mahdiqnb/Heater/docs/LINKEDIN_POST_FA.md

# پست لینکدین — HEATER V2.0

> متن آماده کپی است. فقط اگر خواستی جزئیات شخصی (مثل مدت زمان کار یا اسم پروژه قبلی) را عوض کن.
> عکس برد را خودت باید اضافه کنی: فایل را با نام `board.png` در `docs/images/` بگذار تا ترتیب عکس‌ها کامل شود.

---

## متن پست

🔥 یه مدت درگیر یه چیز کوچیک بودم: اینکه دما ثابت بمونه!

تا حالا شده هویه رو تنظیم کنی، بری یه قطعه رو بردار بیاری، برگردی ببینی دما ۴۰ درجه پریده؟ 😅
یا هیتر یه لحظه قطع و وصل بشه و کارت رو خراب کنه؟

برای همین یه کنترلر دو کاناله ساختم؛ یکی برای هیتر با حلقه بسته PID و یکی برای هویه با توان دستی. هر دو روی یه برد، با یه میکروکنترلر.

🔹 داخلش چی هست؟
- STM32G070RB با کلاک ۶۴ مگاهرتز
- اندازه‌گیری واقعی ترموکوپل Type-K با INA826 و جبران اتصال سرد با SHT40
- دیمر فاز دو کاناله با BTA16 و MOC3021
- LCD گرافیکی ۳۲۰×۲۴۰ با رابط کاربری و فونت اختصاصی
- دو فن PWM، چهار کلید و ذخیره تنظیمات روی فلش

🔹 سخت‌ترین بخشش کجا بود؟
جایی که همه‌چیز «به نظر» درست بود ولی نبود 😂
با توان ثابت ۲٪، دما بین ۱۳۲ تا ۱۶۳ درجه بالا و پایین می‌رفت. مشکل از PID نبود؛ پنجره هدایت تریاک در توان پایین فقط ۴۰۰ میکروثانیه بود و کوچک‌ترین جیتر صفر کراس، توان تحویلی رو حدود ۲۰٪ تغییر می‌داد.
راه‌حل: زیر ۲۰٪ به‌جای کنترل فاز، burst firing (نیم‌سیکل کامل روشن/خاموش) و تفکیک ۰٫۰۱٪ برای خروجی PID.

🔹 یه نکته که خوب یادم موند:
نویز فایر شدن تریاک روی همون خط صفر کراس می‌افته و می‌تونه کانال دیگر رو خاموش کنه. با یه شبکه زمانی مستقل روی TIM3 که فقط با صفر کراس واقعی قفل می‌شه، این مشکل حل شد.

📐 کل پروژه (کد، شماتیک، PCB و BOM) روی گیت‌هاب در دسترسه:
🔗 github.com/mahdiqnb/Heater

اگه پروژه مشابهی داشتی یا سوال فنی داری، کامنت بذار 👇

#Electronics #EmbeddedSystems #HardwareDesign #PCBDesign #ElectronicsEngineering #PCB

---

## ترتیب پیشنهادی عکس‌ها

1. `docs/images/hero.png` — کاور پست
2. `docs/images/ui-home.png` — صفحه اصلی دستگاه
3. `docs/images/ui-settings.png` — صفحه تنظیمات
4. `docs/images/block-diagram.png` — دیاگرام سیستم
5. `docs/images/board.png` — عکس یا رندر برد (خودت اضافه کن)
6. `docs/images/ui-about.png` — صفحه درباره (اختیاری)

## چند نکته

- لینک گیت‌هاب را در اولین کامنت هم بگذار؛ بعضی الگوریتم‌ها پست‌های دارای لینک را کمتر نشان می‌دهند.
- اگر خواستی پست کوتاه‌تر شود، بخش «سخت‌ترین بخشش کجا بود» را نگه دار و یکی از بولت‌های مشخصات را حذف کن؛ همان بخش بیشترین تعامل را می‌گیرد.
- برای عکس برد، نور یکنواخت و پس‌زمینه تیره (مثل بقیه تصاویر) بهترین نتیجه را می‌دهد.
