mahdiqnb/Heater/hardware/BOM/My Heater BOM.xlsx

Comment | Designator | Quantity | Price | Price x Quantity | Link | UNIT PRICE | TOTAL
AMS1117 3.3V | A600 | 1 |  |  | lionelectronic (https://lionelectronic.ir/products/868-AMS1117-3.3) | 180699 | 180699
Bat54s | B100, B101, B102, B103, B104, B106, B107, B108, B109, B110 | 10 |  |  | lionelectronic (https://lionelectronic.ir/products/2416-BAT54S) | 99477 | 994770
BC817 | B700, B701, B702 | 3 |  |  | lionelectronic (https://lionelectronic.ir/products/134-BC817-40) | 39465 | 118395
Cap 4.7uf 0805 | C100, C604, C904 | 3 |  |  | lionelectronic (https://lionelectronic.ir/products/3734-CL21A475KBQNNNE) | 51156 | 153468
Cap 100nf 0805 | C101, C102, C103, C104, C401, C403, C404, C501, C800, C801, C802, C803 | 12 |  |  | lionelectronic (https://lionelectronic.ir/products/2791-CL21B104KBCNNNC) | 16656 | 199872
Cap 10uf 0805 | C105, C400, C402, C500, C608, C609, C610 | 7 |  |  | lionelectronic (https://lionelectronic.ir/products/3069-C2012X5R1H106K125AC) | 130305 | 912135
Cap 10nf 0805 | C600, C603, C606, C900, C903, C906 | 6 |  |  | lionelectronic (https://lionelectronic.ir/products/2788-TCC0805X7R103K500DT) | 7350 | 44100
Cap 220uf 10x10 | C601, C602, C901, C902, C905, C907 | 6 |  |  | lionelectronic (https://lionelectronic.ir/products/3016-VZH221M1HTR-1010) | 267510 | 1605060
Cap 3300uf 6.3X5.6 SMD 10V | C605 | 1 |  |  | lionelectronic (https://lionelectronic.ir/products/3016-VZH221M1HTR-1010) | 267510 | 267510
Cap 100uf 6.3X5.6 SMD 10V | C607 | 1 |  |  | lionelectronic (https://lionelectronic.ir/products/6377-HV1H107M1010PZ) | 410211 | 410211
Cap 22uf 1206 | C908, C909 | 2 |  |  | lionelectronic (https://lionelectronic.ir/products/1033-C3216X7R1H475K160AC) | 102150 | 204300
PESD3V3U1UA,115 | D100, D101, D102, D103, D104, D105, D106, D107, D108, D110 | 10 |  |  | lionelectronic (https://lionelectronic.ir/products/6714-SD03C) | 20274 | 202740
BTA16-600CW3G | D200, D201 | 2 |  |  |  | INVALID | 0
LED Green 0805 | D600, D902, D903 | 3 |  |  | lionelectronic (https://lionelectronic.ir/products/2207-XL-2012SURC) | 9458 | 28374
LED Yellow0805 | D601 | 1 |  |  | lionelectronic (https://lionelectronic.ir/products/2207-XL-2012SURC) | 9458 | 9458
LED Blue 0805 | D700, D701, D702, D800, D801, D802, D803 | 7 |  |  | lionelectronic (https://lionelectronic.ir/products/2207-XL-2012SURC) | 9458 | 66206
LED Red 0805 | D900, D901 | 2 |  |  | lionelectronic (https://lionelectronic.ir/products/2207-XL-2012SURC) | 9458 | 18916
ferrite bead 0805 | F100 | 1 |  |  | lionelectronic (https://lionelectronic.ir/products/4142-BLM21AG102SN1D) | 33552 | 33552
Inductor 15uh 7.3x6.6 | I600, I900 | 2 |  |  | lionelectronic (https://lionelectronic.ir/products/5591-TMPC0603H-150MG-D) | 216225 | 432450
USB A | J100 | 1 |  |  | lionelectronic (https://lionelectronic.ir/products/4122-AF90CBJ) | 121500 | 121500
9 PIN XH 2.54mm | LCD connector100 | 1 |  |  | lionelectronic (https://lionelectronic.ir/products/4259-2.54mm-9P-ZZ-MS) | 87330 | 87330
MutliTurn 100k Ohm Dip | M900 | 1 |  |  | lionelectronic (https://lionelectronic.ir/products/3239-3296W-1-104) | 1018350 | 1018350
phoenix 2 pin 5mm | P200 | 1 |  |  | lionelectronic (https://lionelectronic.ir/products/6049-KF2EDGR%2BK-5.08-2P) | 158914 | 158914
phoenix 4 pin 5mm | P201 | 1 |  |  | lionelectronic (https://lionelectronic.ir/products/6051-KF2EDGR%2BK-5.08-4P) | 304436 | 304436
Resistor 200 Ohm 0805 % | R200, R203 | 2 |  |  | lionelectronic (https://lionelectronic.ir/products/1409-SCR0805F200R) | 3118 | 6236
Res 200 Ohm Dip | R201, R202, R204, R205 | 4 |  |  | skytech (https://www.skytech.ir/product_details.aspx?ID_Parts=27167&200-OHM-RESISTOR) | 4779 | 19116
Res 100K Ohm Dip 0.25W | R301, R302, R303, R304 | 4 |  |  | eshop (https://eshop.eca.ir/مقاومت-14-وات/744-مقاومت-100k-اهم-14w.html) | 3400 | 13600
Res 100 Ohm 0805 % | R402, R403, R405 | 3 |  |  | lionelectronic (https://lionelectronic.ir/products/1561-RS-05K101JT) | 2955 | 8865
Res 330 Ohm 0805 % | R404,R601, R603 | 3 |  |  | lionelectronic (https://lionelectronic.ir/products/1414-SER0805F330R) | 3118 | 9354
Resistor 6.8K Ohm 0805 % | R600, R901 | 2 |  |  | lionelectronic (https://lionelectronic.ir/products/1583-0805W8J0682T5E) | 2955 | 5910
Resistor 2.2K Ohm 0805 % | R602 | 1 |  |  | lionelectronic (https://lionelectronic.ir/products/1577-0805W8J0222T5E) | 2955 | 2955
Resistor 120 Ohm 0805 5% | R700, R703, R706, R801, R803, R806, R811 | 7 |  |  | lionelectronic (https://lionelectronic.ir/products/1562-0805W8J0121T5E) | 2955 | 20685
Resistor 10k Ohm 0805 5% | R701, R702, R704, R705, R707, R708,'R800, R804, R807, R809,'R300, R400, R401 | 13 |  |  | lionelectronic (https://lionelectronic.ir/products/2426-0805W8F1002T5E) | 3118 | 40534
Resistor 220 Ohm 0805 % | R802, R805, R808, R810 | 4 |  |  | lionelectronic (https://lionelectronic.ir/products/1410-SER0805F220R) | 3118 | 12472
Resistor 20K Ohm 0805 % | R900 | 1 |  |  | lionelectronic (https://lionelectronic.ir/products/1457-0805W8F2002T5E) | 3118 | 3118
Resistor 1.5k Ohm 0805 % | R902, R903, R904, R905 | 4 |  |  | lionelectronic (https://lionelectronic.ir/products/1575-SER0805J1K5) | 2955 | 11820
STM32G070RBT6 | S100 | 1 |  |  | lionelectronic (https://lionelectronic.ir/products/2544-STM32G070RBT6) | 1861830 | 1861830
SS34 | S500, S501, S502, S503, S504, S505, S506, S507, S600, S605, S900 | 11 |  |  | lionelectronic (https://lionelectronic.ir/products/2816-SS34) | 37238 | 409618
Push Button Switch SMD | S800, S801, S802, S803 | 4 |  |  | lionelectronic (https://lionelectronic.ir/products/4096-TS66125TP) | 79650 | 318600
ATE1D-2M3-10-Z | S903, S904 | 2 |  |  |  | INVALID | 0
TPS5450DDAR | T601, T901 | 2 |  |  | lionelectronic (https://lionelectronic.ir/products/2593-TPS5450DDAR) | 1374912 | 2749824
MOC3021 | U200, U201 | 2 |  |  |  | INVALID | 0
H11AA1 | U300 | 1 |  |  |  | INVALID | 0
SHT40-AD1B-R2 | U400 | 1 |  |  | lionelectronic (https://lionelectronic.ir/products/2536-SHT40-AD1B-R2) | 1381980 | 1381980
INA826AIDR | U401 | 1 |  |  | lionelectronic (https://lionelectronic.ir/products/4468-INA826AIDR) | 896850 | 896850
L293D | U500 | 1 |  |  |  | INVALID | 0
6 PIN XH 2.54mm | XH100, XH800 | 2 |  |  | lionelectronic (https://lionelectronic.ir/products/4256-2.54mm-6P-ZZ-MS) | 56420 | 112840
2 pin XH 2.54mm | XH400, XH500, XH501, XH600, XH900, XH901 | 6 |  |  | lionelectronic (https://lionelectronic.ir/products/4252-2.54mm-2P-ZZ-MS) | 24282 | 145692
 |  | 1 |  |  | lionelectronic (https://lionelectronic.ir/products/5474-KTSC-61Y-) | 103095 | 103095
 |  |  |  |  |  |  | 15707740
