mahdiqnb/Heater/hardware/My Heater.pdf

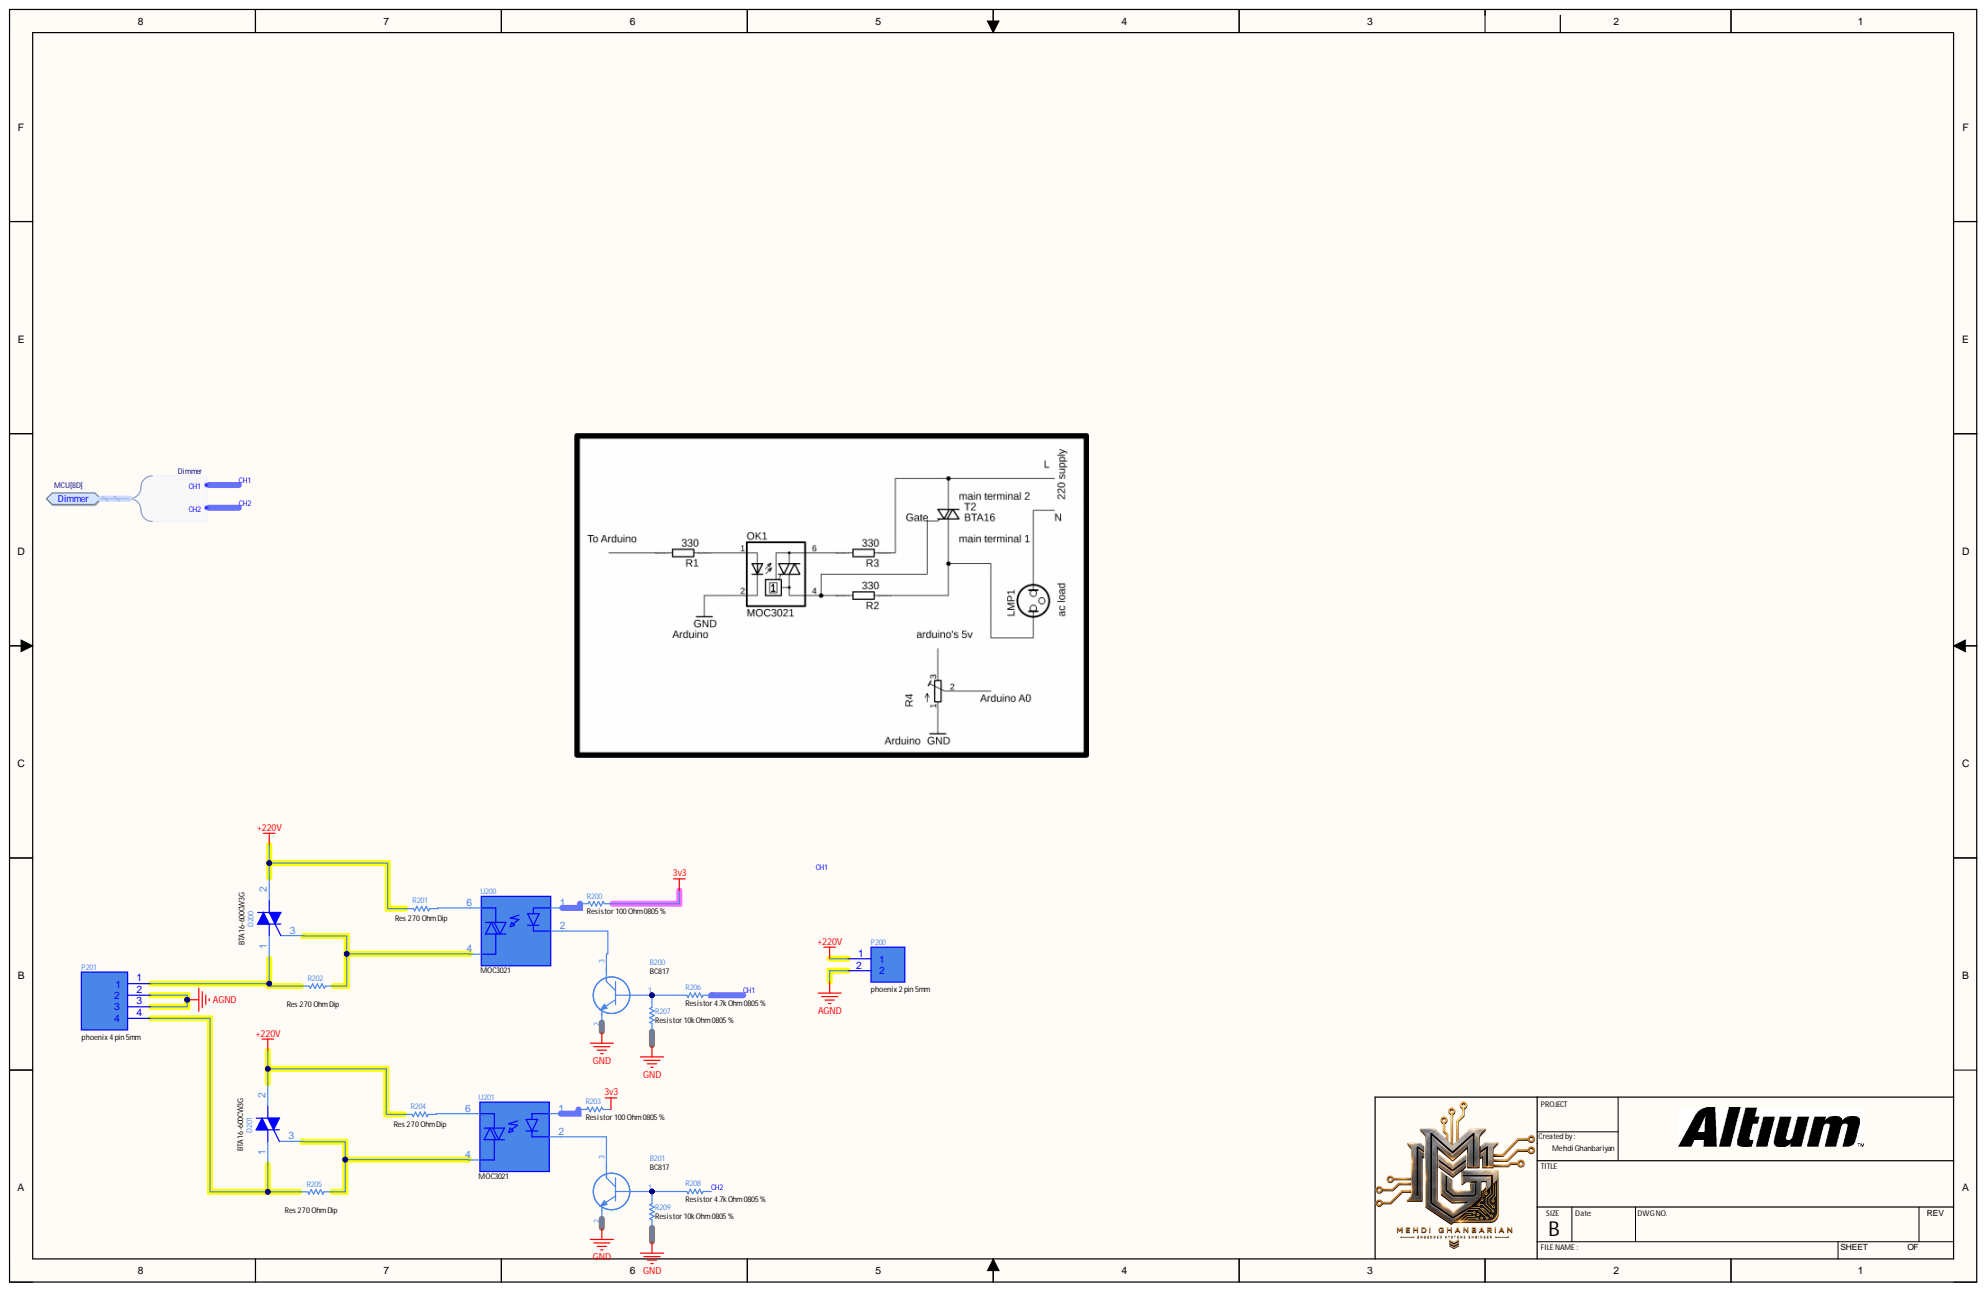
[picture p6: page 1]

SIZE B | Date: | DWGNO. | REV

FILE NAME : | SHEET OF

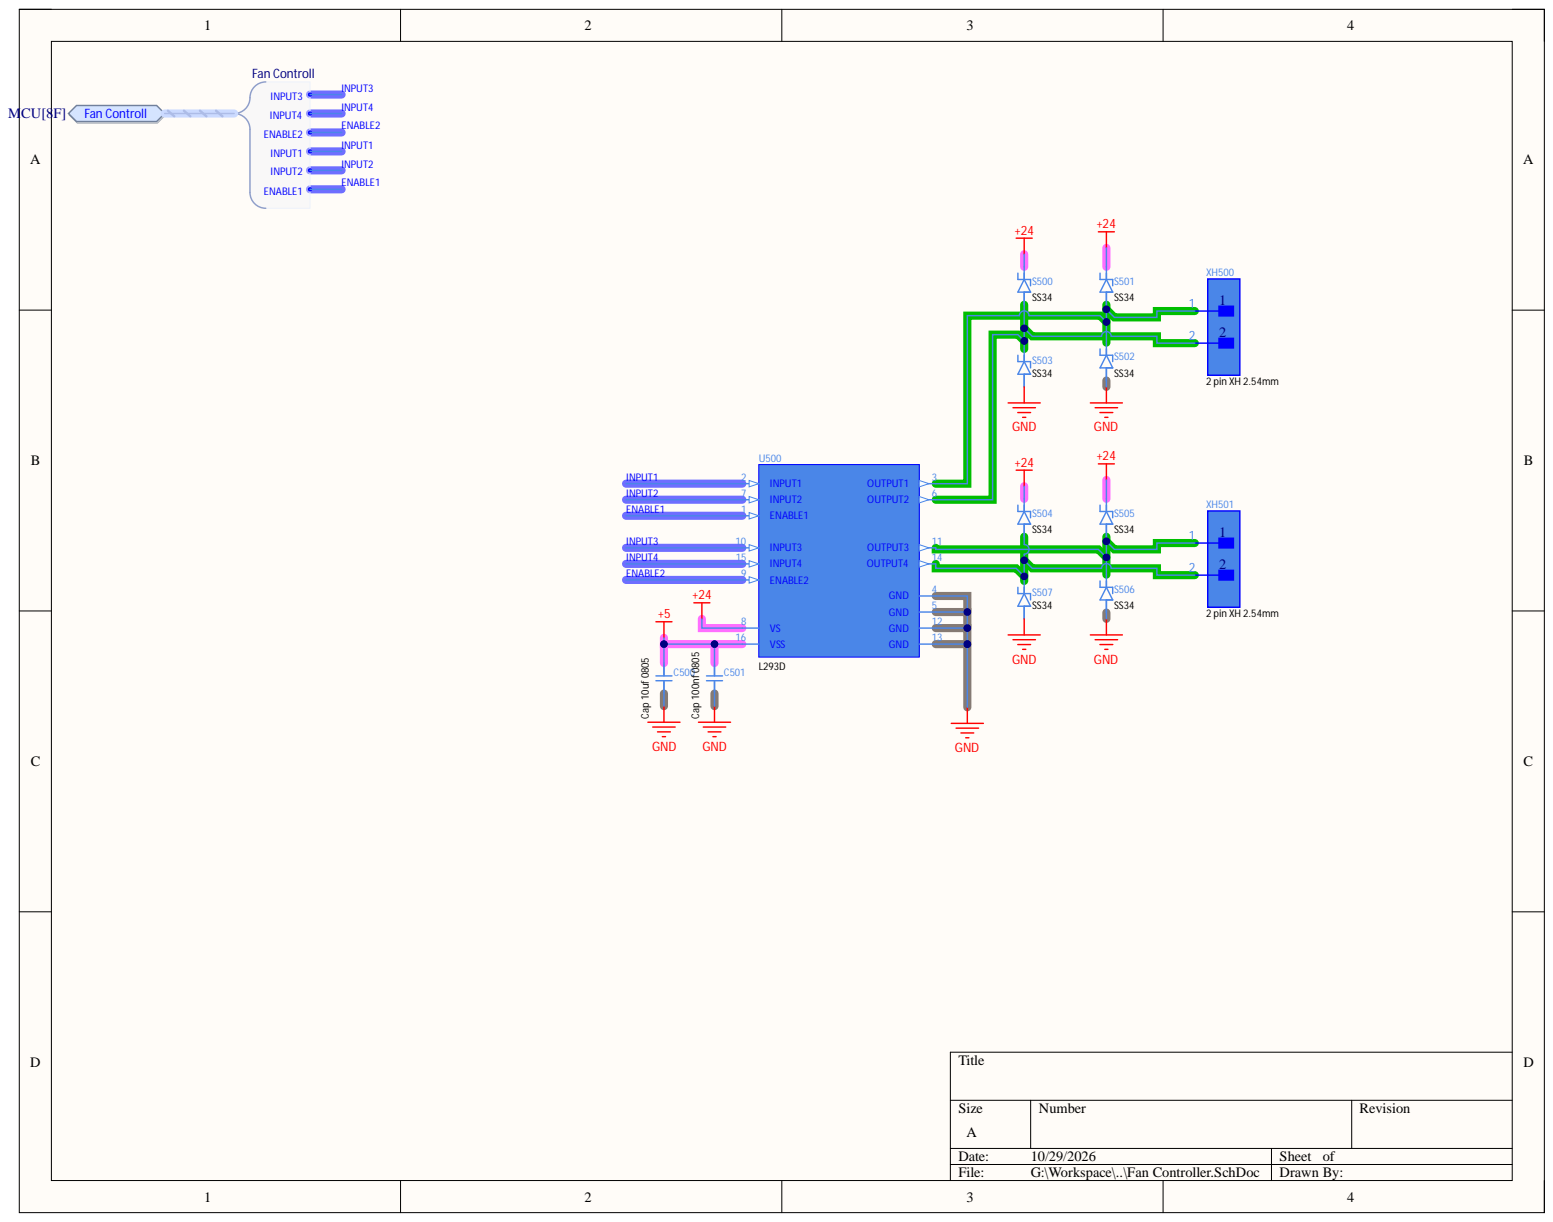
[picture p7: page 2]

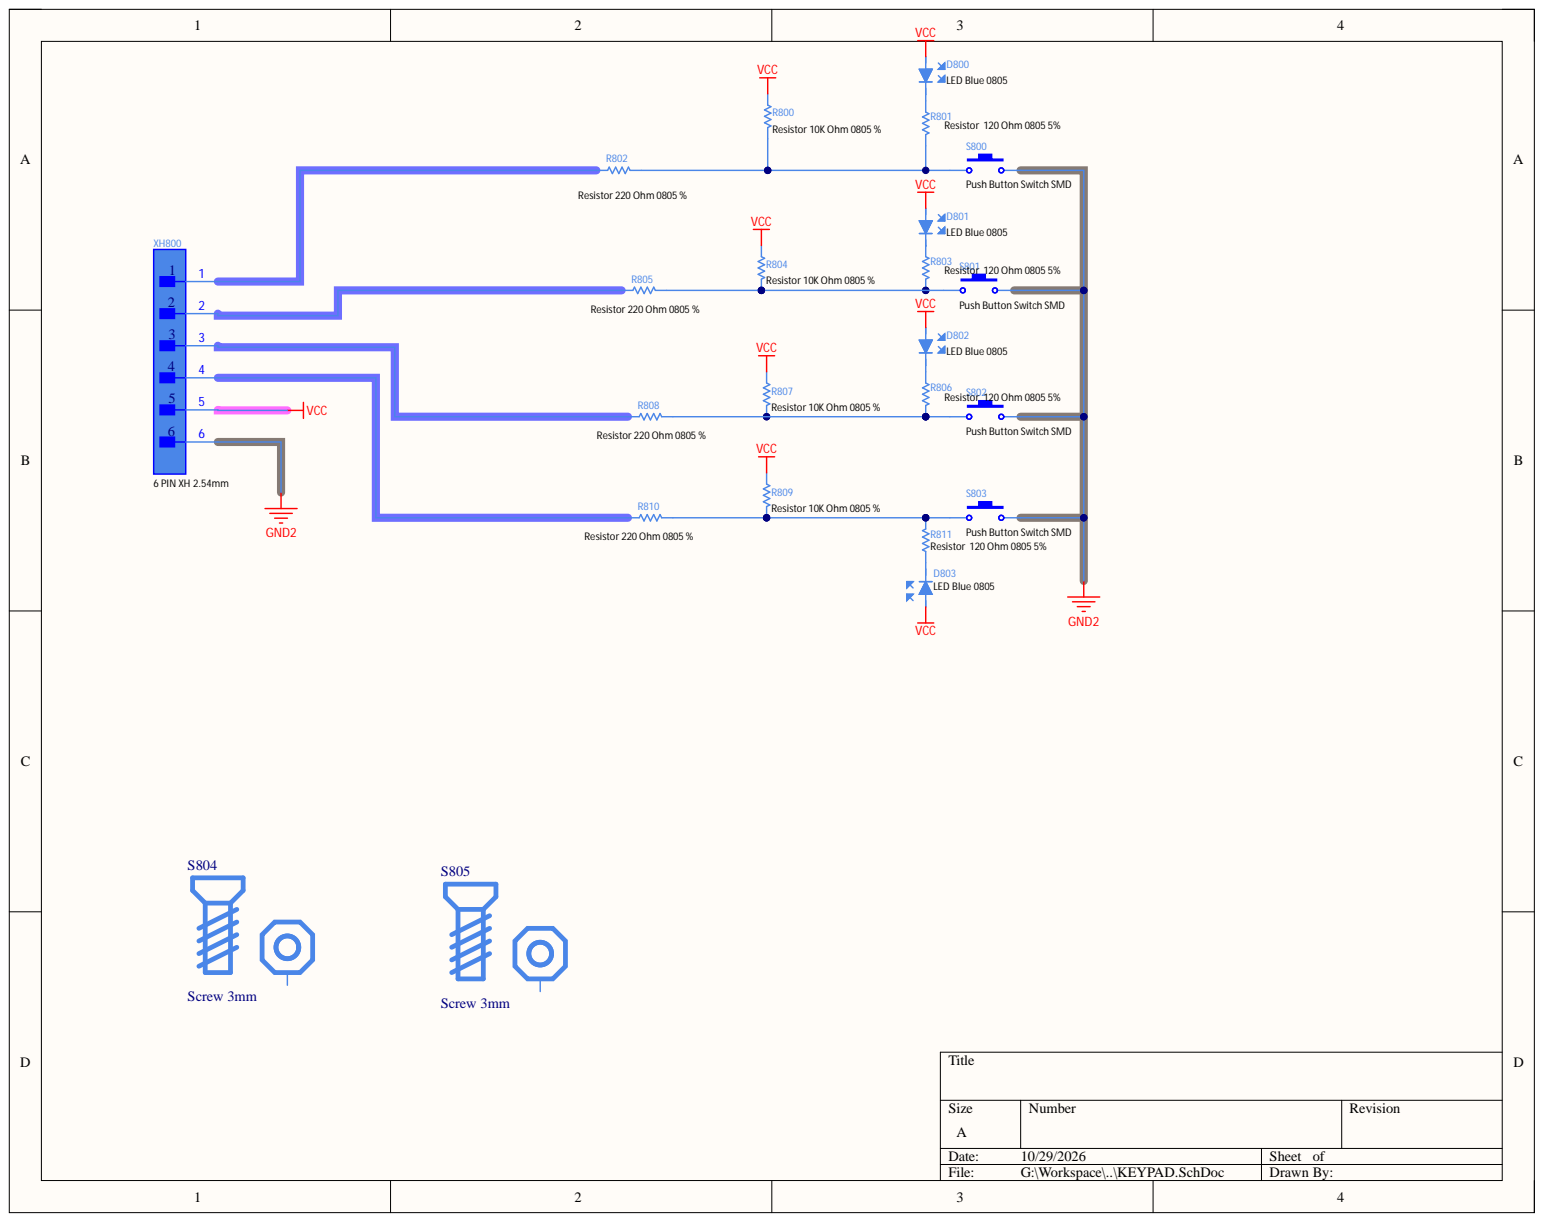
[picture p8: page 3]

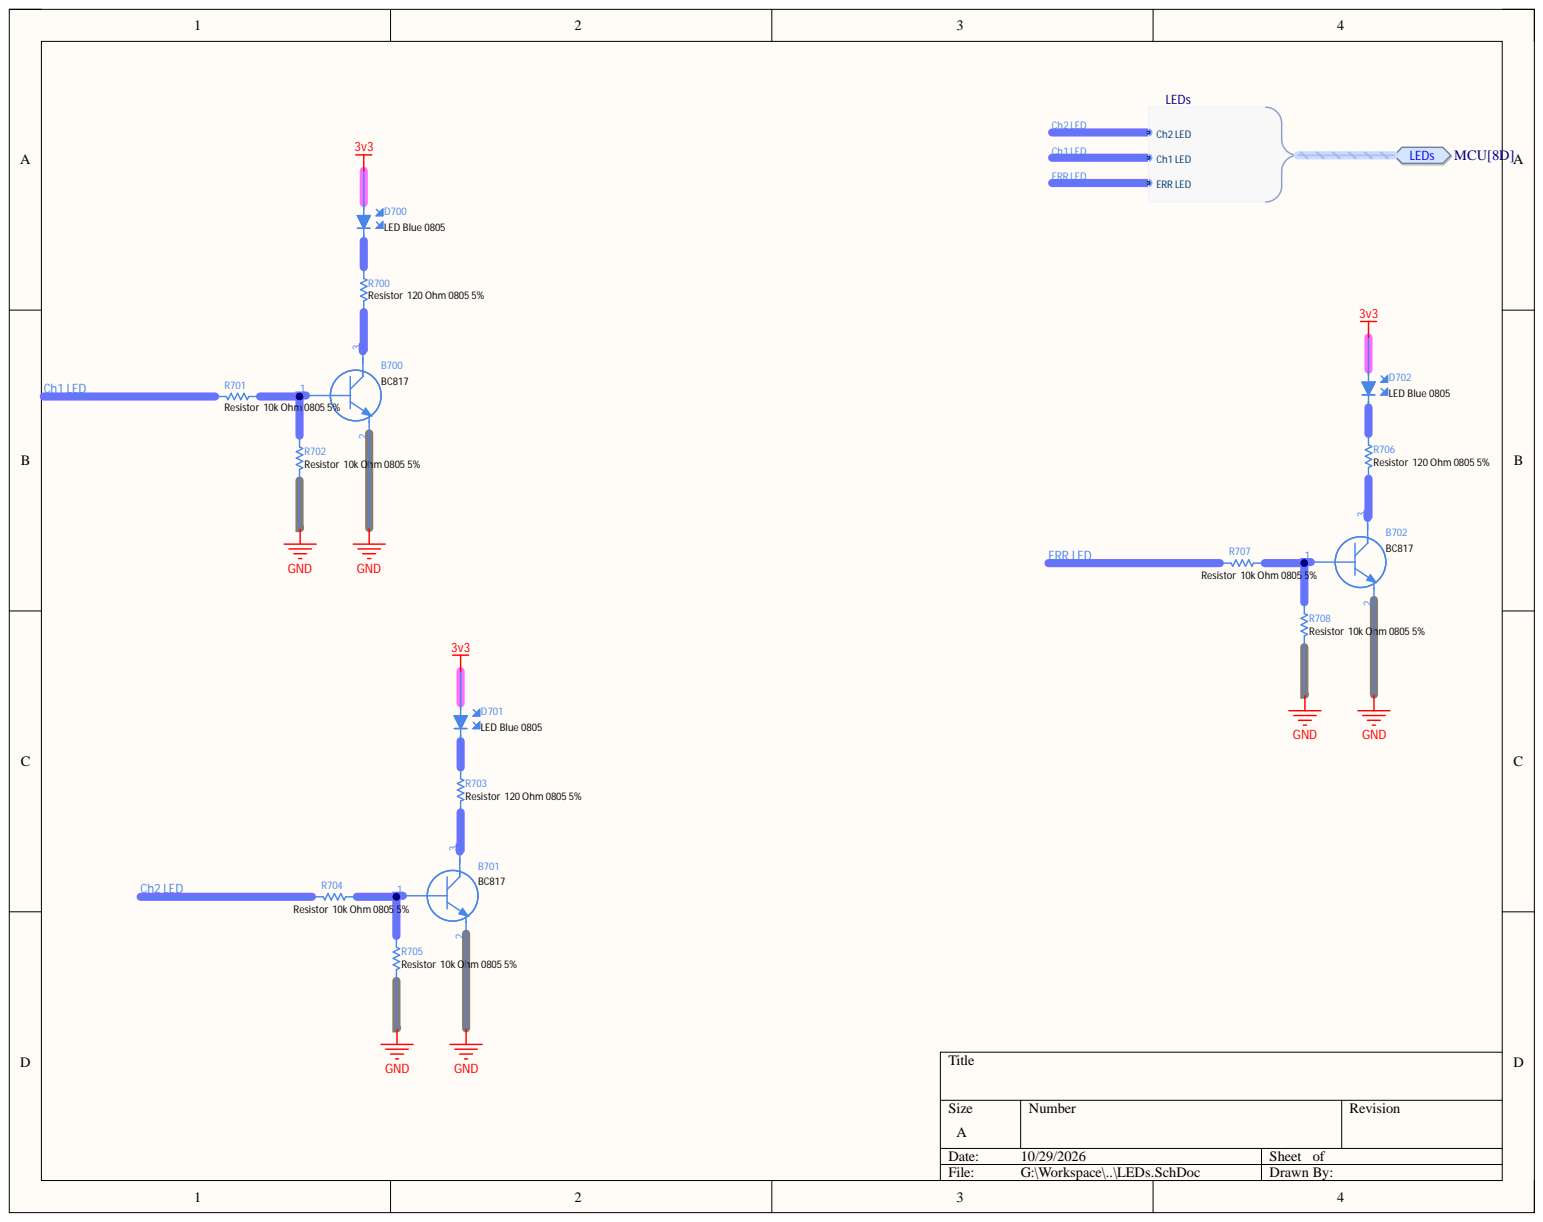
[picture p9: page 4]

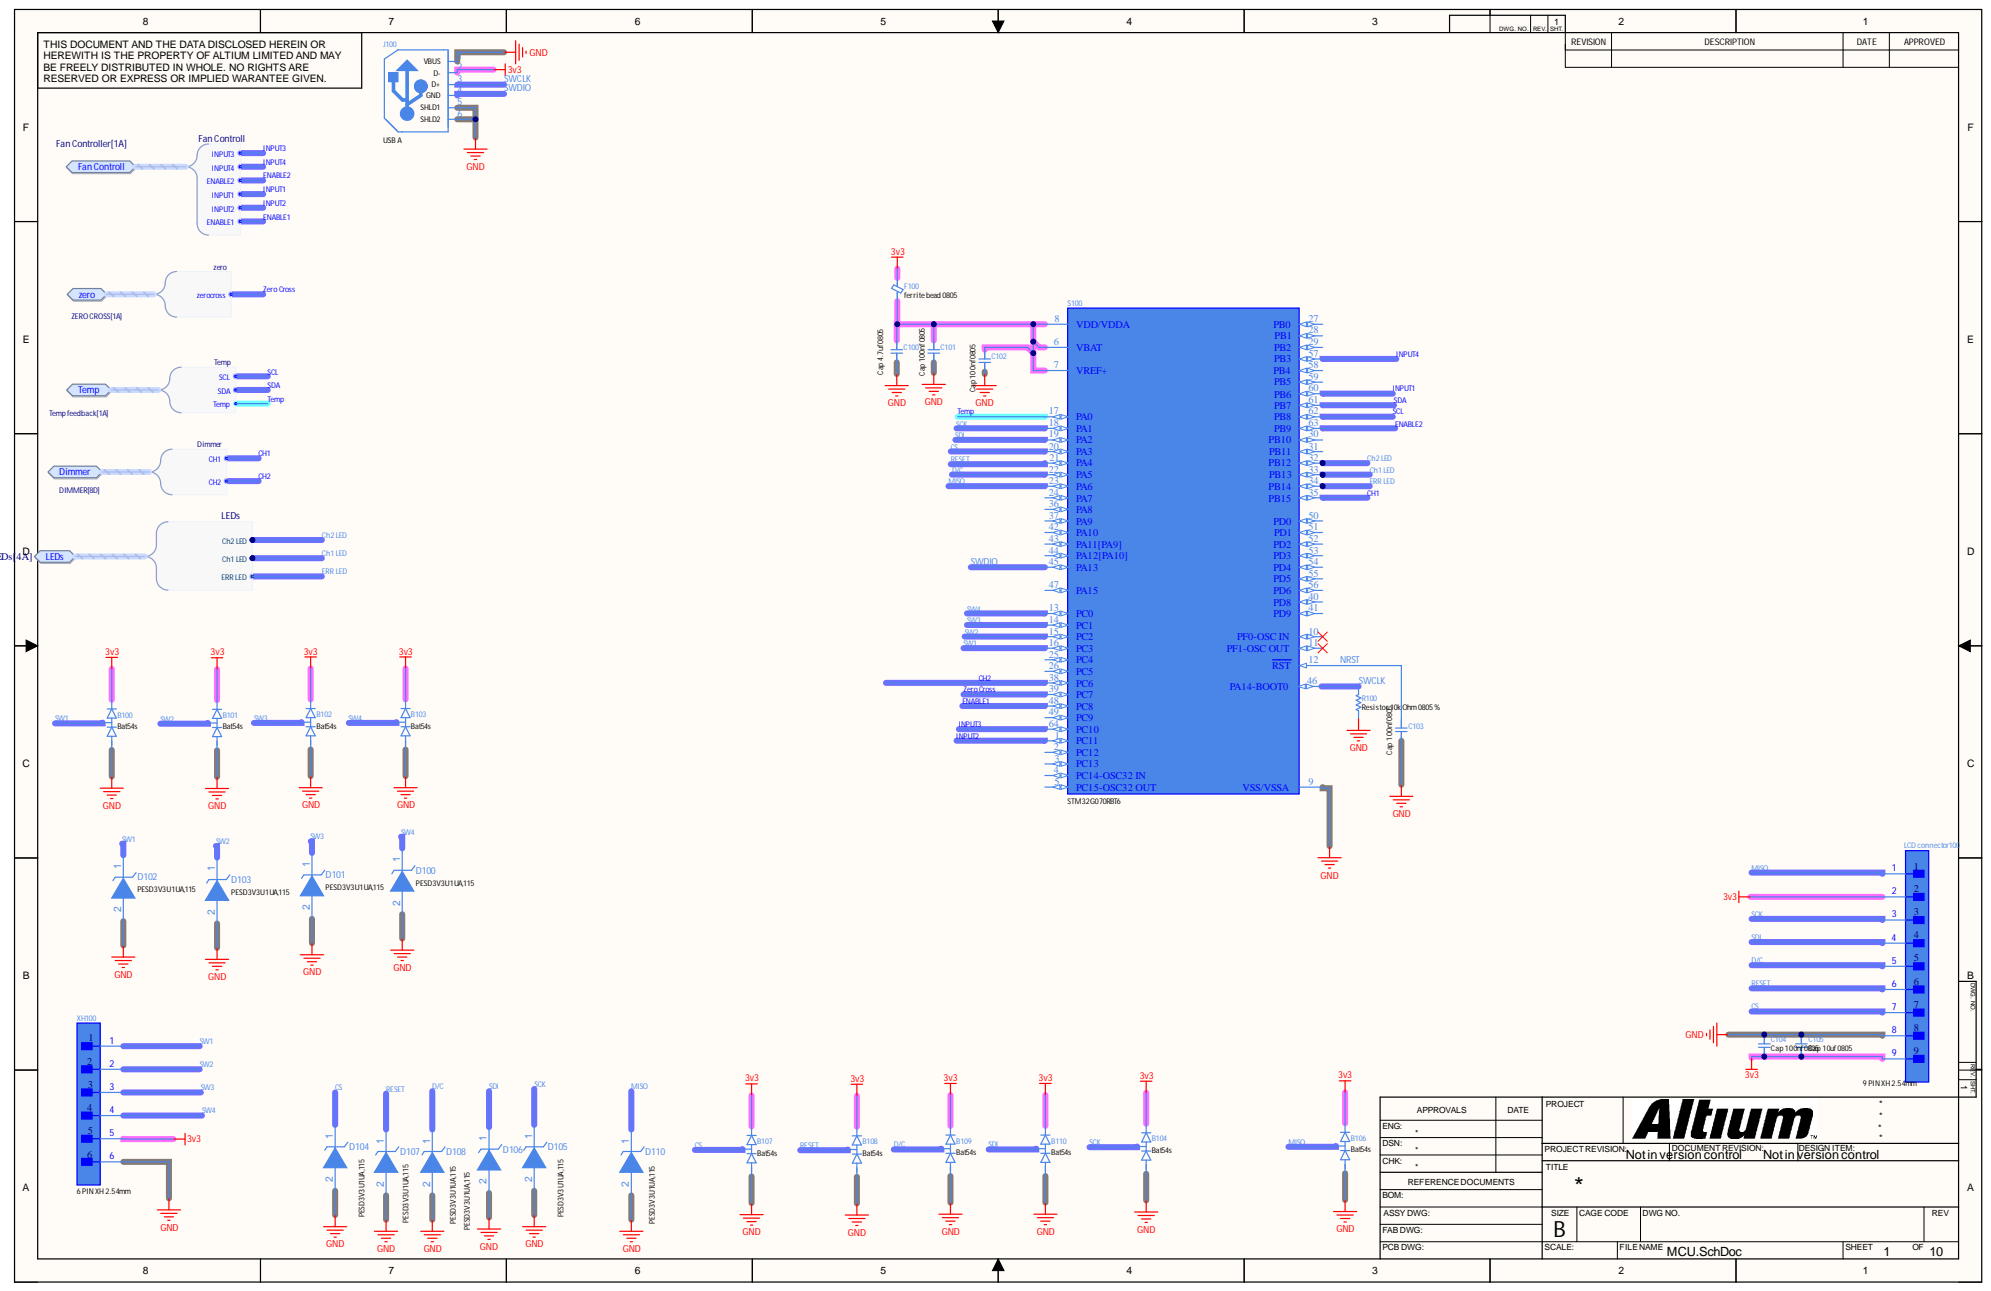
[picture p10: page 5]

8 | 7 | 6 | 5 | 4 | 3 | | DWG. NO. | REV. | 1 SHT. | 2 | 1

THIS DOCUMENT AND THE DATA DISCLOSED HEREIN OR HEREWITH IS THE PROPERTY OF ALTIUM LIMITED AND MAY BE FREELY DISTRIBUTED IN WHOLE. NO RIGHTS ARE RESERVED OR EXPRESS OR IMPLIED WARANTEE GIVEN. | | 3v3 F100 ferritebead 0805 | REVISION | DESCRIPTION | DATE | APPROVED

PC5 26 | SWCLK R100 Resistor 10k Ohm0805 %

REV. SHT. DWG. NO.

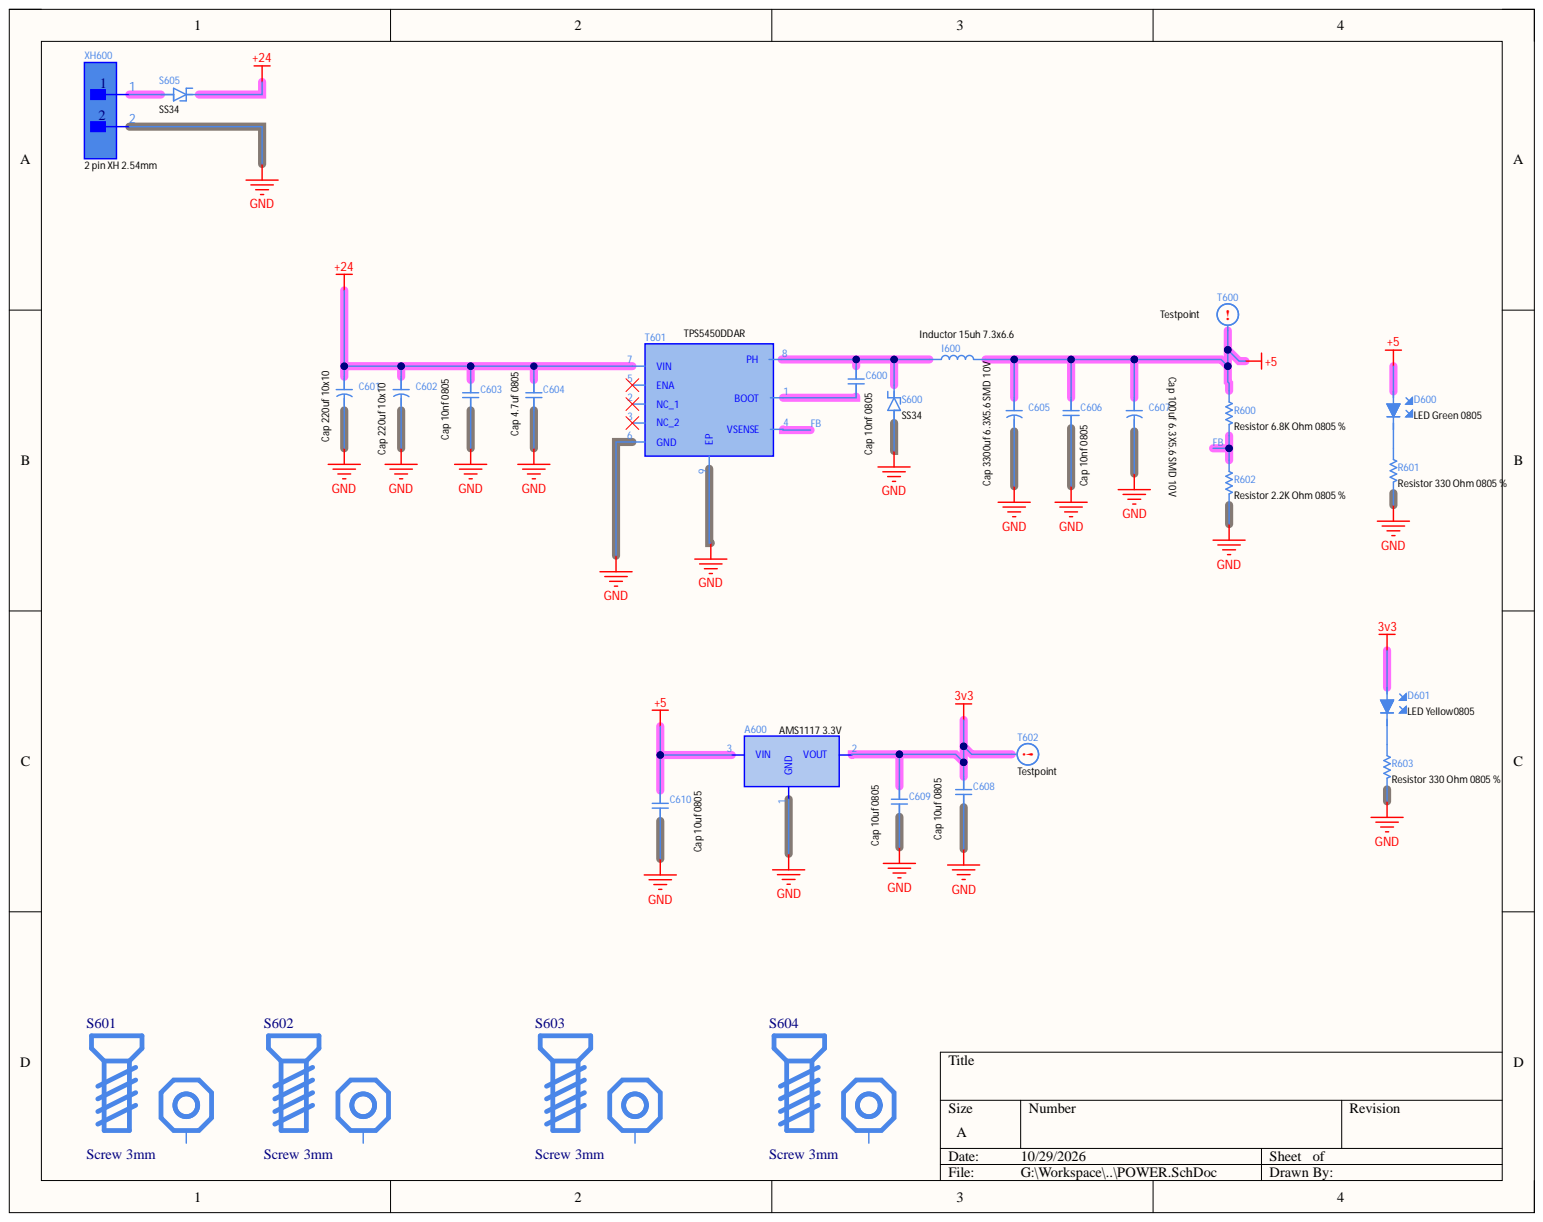
[picture p11: page 6]

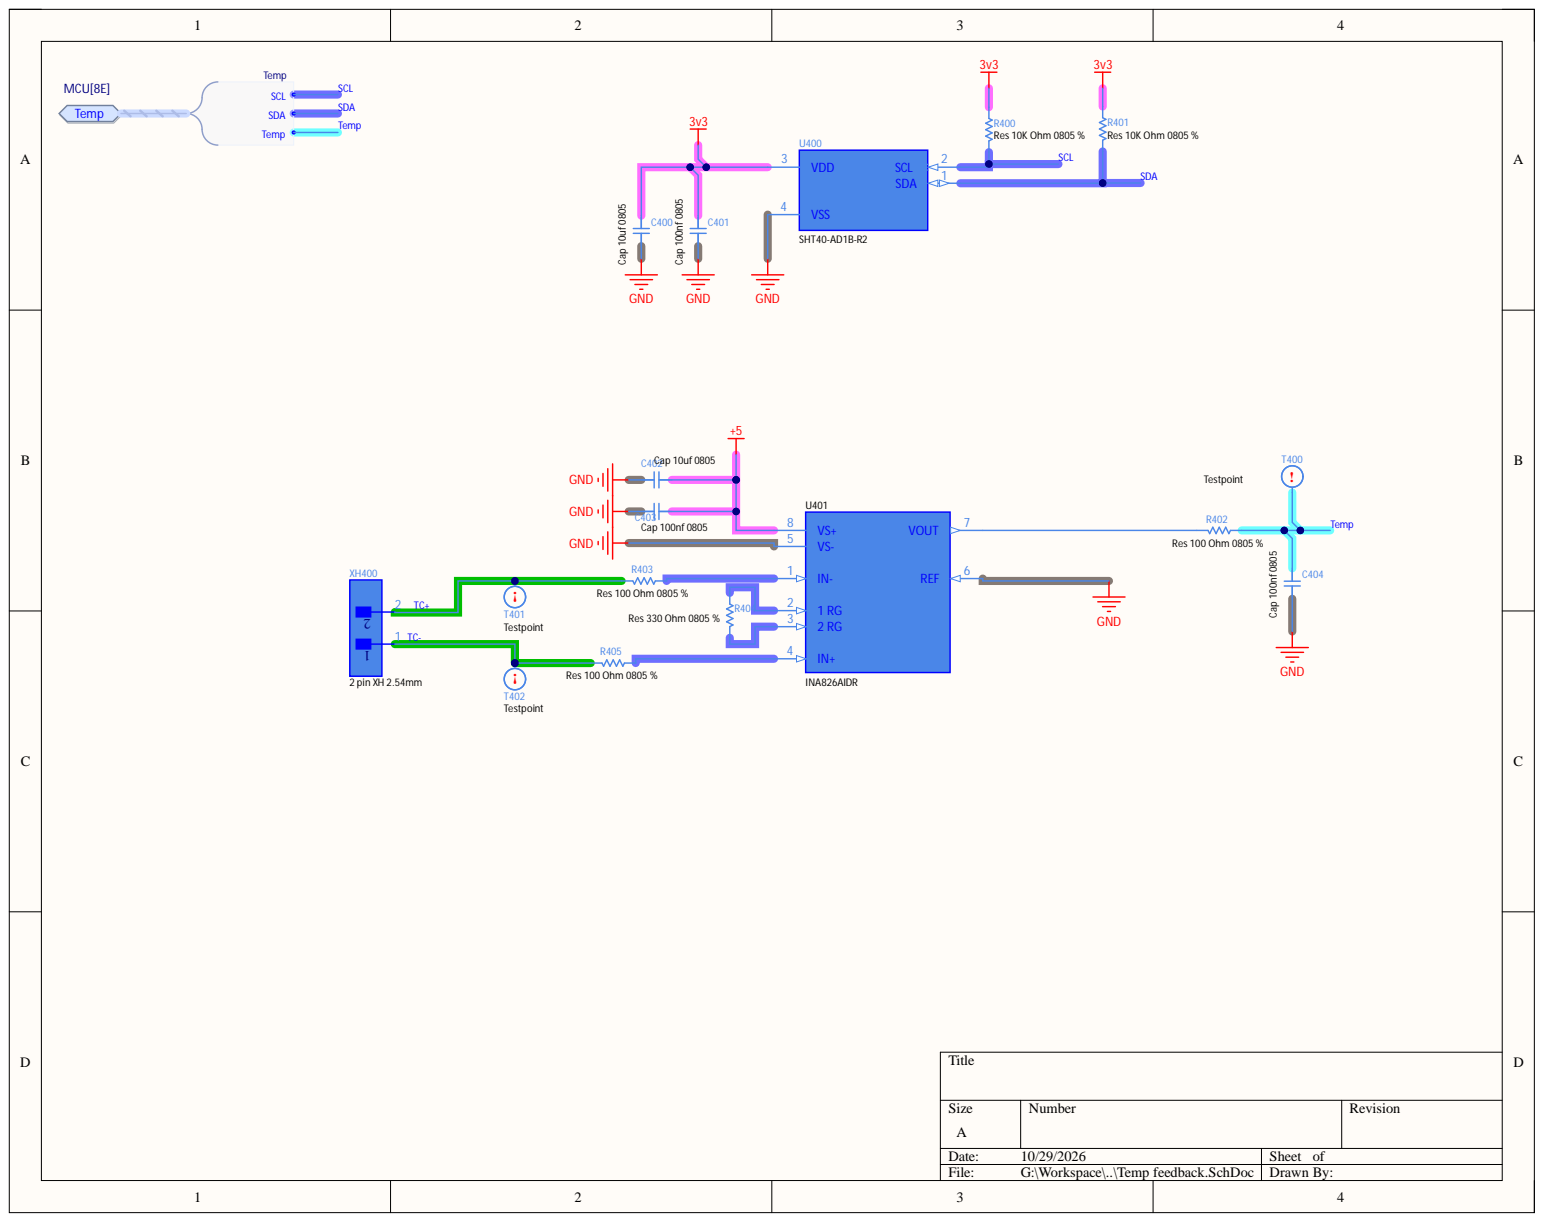
[picture p12: page 7]

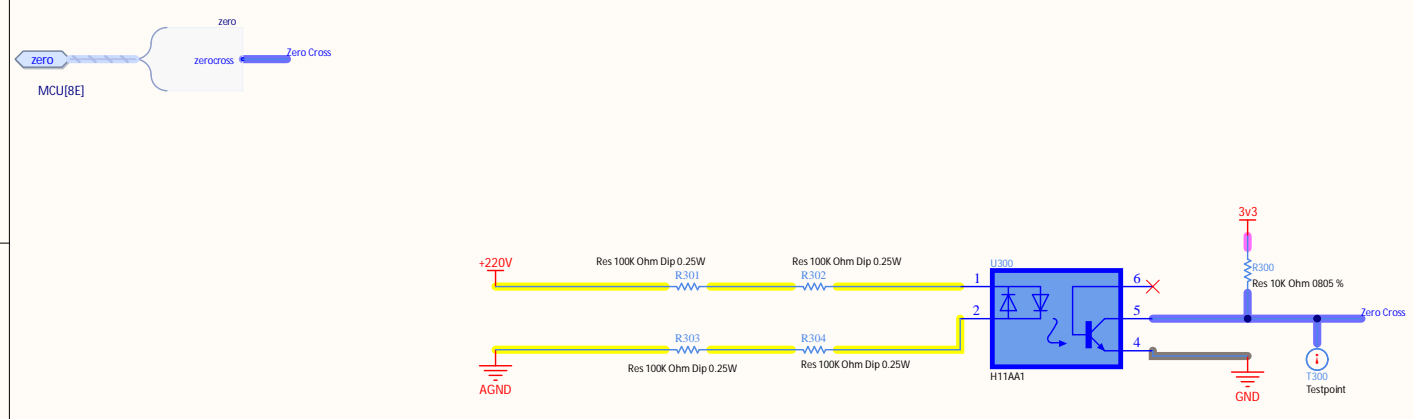
[picture p13: page 8]
