mahdiqnb/Heater/(list of files, drawings)

Other design files:
hardware/My heater.PcbDoc
