mahdiqnb/Heater/Core/Inc/main.h

#define SW4_Pin GPIO_PIN_0
#define SW4_GPIO_Port GPIOC
#define SW3_Pin GPIO_PIN_1
#define SW3_GPIO_Port GPIOC
#define SW2_Pin GPIO_PIN_2
#define SW2_GPIO_Port GPIOC
#define SW1_Pin GPIO_PIN_3
#define SW1_GPIO_Port GPIOC
#define TEMP_INPUT_Pin GPIO_PIN_0
#define TEMP_INPUT_GPIO_Port GPIOA
#define RESET_Pin GPIO_PIN_4
#define RESET_GPIO_Port GPIOA
#define D_C_Pin GPIO_PIN_5
#define D_C_GPIO_Port GPIOA
#define CH2_LED_Pin GPIO_PIN_12
#define CH2_LED_GPIO_Port GPIOB
#define CH1_LED_Pin GPIO_PIN_13
#define CH1_LED_GPIO_Port GPIOB
#define ERR_LED_Pin GPIO_PIN_14
#define ERR_LED_GPIO_Port GPIOB
#define CH1_Pin GPIO_PIN_6
#define CH1_GPIO_Port GPIOC
#define CH2_Pin GPIO_PIN_15
#define CH2_GPIO_Port GPIOB
#define ZERO_CROSS_Pin GPIO_PIN_7
#define ZERO_CROSS_GPIO_Port GPIOC
#define ZERO_CROSS_EXTI_IRQn EXTI4_15_IRQn
#define Ch1_PWM_Pin GPIO_PIN_8
#define Ch1_PWM_GPIO_Port GPIOC
#define Ch2_PWM_Pin GPIO_PIN_9
#define Ch2_PWM_GPIO_Port GPIOB
