mahdiqnb/Heater/Core/Inc/logo.h

#ifndef LOGO_DATA_H
#define LOGO_DATA_H
/*
 * Boot splash image, generated from G:\Workspace\LOGO\logo.png
 * (alpha cropped, LANCZOS scaled, composited on black, 256-colour
 * median-cut palette with Floyd-Steinberg dithering).
 * Header-only so no CubeIDE build file has to be touched.
 */
#include <stdint.h>

#define LOGO_W 240
#define LOGO_H 219
#define LOGO_X 40
#define LOGO_Y 10
#define LOGO_PAL_N 256

/* RGB565 palette */
static const uint16_t logo_pal[LOGO_PAL_N] = {
    0xFFBA, 0xFF54, 0xEEF7, 0xFEF0, 0xEE73, 0xFE4D, 0xDE76, 0xD635,
    0xEDED, 0xF5CA, 0xE5F1, 0xDDAE, 0xCDF5, 0xCDB3, 0xC5D6, 0xBDB5,
    0xED69, 0xDD6C, 0xDD0A, 0xE507, 0xCD71, 0xD54E, 0xCD0E, 0xD50B,
    0xBD74, 0xBD52, 0xB554, 0xB533, 0xBD10, 0xAD12, 0xAD13, 0xA4F2,
    0xDCC8, 0xDC87, 0xCCCA, 0xCC89, 0xD445, 0xCC47, 0xCC04, 0xC405,
    0xB4D0, 0xAC8E, 0xBCAB, 0xBC6A, 0xB44B, 0xB40A, 0xBC27, 0xB407,
    0xA4D2, 0x9CB2, 0xA4B1, 0x9C91, 0xA46F, 0x9C70, 0x9471, 0x9450,
    0x942E, 0x8C2F, 0xA42B, 0x9C0C, 0x8C30, 0x8C30, 0x8C0F, 0x840F,
    0xC3C4, 0xC3A3, 0xABC7, 0xB3A5, 0x9BEB, 0x93AA, 0xA3C8, 0x9B87,
    0xBB63, 0xA365, 0x9369, 0x9B46, 0xAB22, 0xAAC1, 0x9325, 0x9AC3,
    0x83CE, 0x8BCD, 0x7BCF, 0x7BCE, 0x838D, 0x7B8D, 0x8B8A, 0x838B,
    0x836B, 0x7B2A, 0x8B27, 0x8328, 0x8AE5, 0x82E7, 0x82C5, 0x7BAE,
    0x738E, 0x738D, 0x736D, 0x736D, 0x734B, 0x6B4D, 0x6B4C, 0x732B,
    0x6B2C, 0x730A, 0x730A, 0x6B2C, 0x632C, 0x630B, 0x630C, 0x6AEA,
    0x6AC9, 0x72C8, 0x6AA8, 0x62EB, 0x62EB, 0x62CA, 0x62A9, 0x5AEB,
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
    0x03, 0x09, 0x10, 0x20, 0x20, 0x10, 0x10, 0x03, 0x4A, 0xFF, 0xEA, 0xFF, 0xFF, 0xFF, 0xFF, 0xFF,
    0xFF, 0xFF, 0xFF, 0xFF, 0xFF, 0xFF, 0xFF, 0xFF, 0xFF, 0xFF, 0xFF, 0xFF, 0xFF, 0xFF, 0xFF, 0xFF,
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
};

#endif /* LOGO_DATA_H */
