mahdiqnb/Heater/Core/Inc/dimmer.h

#ifndef DIMMER_H
#define DIMMER_H
#include <stdint.h>

void Dimmer_Init(void);
void Dimmer_SetHeater(uint8_t percent); /* 0..100 */
/* Same channel, but with 0.01 % resolution. The firing angle is interpolated
 * between table entries and the fractional tick is delta-sigma dithered over
 * successive half-cycles, so the average power follows the request far more
 * finely than the 1 % table grid. Use this for the PID output. */
void Dimmer_SetHeaterFine(float percent); /* 0..100, 0.01 % steps */
void Dimmer_SetIron(uint8_t percent);   /* 0..100 */
uint8_t Dimmer_GetHeater(void);
uint8_t Dimmer_GetIron(void);
/* call from the 50us timer tick ISR */
void Dimmer_TickISR(void);
/* Call from the zero-cross EXTI callback. */
void Dimmer_ZeroCross(void);
/* 1 while mains zero crossings keep arriving (0 = no sync, nothing can fire). */
uint8_t Dimmer_ZcOk(void);

#endif
