mahdiqnb/Heater/(commit log)

2026-10-25 HEATER V2.0: STM32G070 firmware with ILI9341 UI, PID heater control, 2-ch phase dimmer, fan PWM
2026-10-26 Rework the heater loop and add a second fan channel
    The temperature loop could not hold a setpoint (the integrator was clamped to
    a few percent of output), the derivative acted on raw ADC noise, and a
    disconnected thermocouple looked like a cold heater, so power stayed at 100 %.
    Convert the reading through the type-K inverse polynomial with cold junction
    compensation, oversample the ADC, integrate in output units with real
    anti-windup, put the derivative on the measurement and stop the element when
    power produces no heat.
    The two L293D outputs share the 24 V rail, so the 12 V fan on XH501 is now a
    separate channel clamped to 50 % duty, and the dimmer drops the gate if the
    zero-cross signal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
2026-10-26 Let the user clear the no-heat trip with the HEATER switch
    The trip used to force the enable flag off, so the SETTINGS page still showed
    ON while nothing could re-arm it. The controller already holds the output at
    zero while the fault is latched, so the flag now keeps the user's choice and a
    fresh ON acknowledges the fault.
    🤖 Generated with Codebuff
2026-10-26 Fix the key map, add hold-to-repeat and a box fan mute switch
    The arrow keys were wired to the wrong pins, so UP/DOWN/LEFT/RIGHT did not
    match the board: DOWN was on PC2, LEFT on PC1 and RIGHT on PC0. They now read
    SW1=PC3 up, SW2=PC2 left, SW3=PC1 right, SW4=PC0 down.
    Holding a key repeats it: one step per tap, then an accelerating repeat after
    0.7 s that reaches 35 ms per step by the 3 s mark, so a 200 -> 400 C setpoint
    change takes seconds instead of 200 taps. The settings page repaints only the
    row that changed, so the repeat stays responsive over the bit-banged SPI bus.
    New defaults are 50 % iron, 50 % heater fan and 25 % box fan, plus a BOX FAN
    row on the settings page that silences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
2026-10-27 fix: dimmer full-on mode, LED order, double-click, manual heater %, debug ADC vars
2026-10-27 fix: heater/iron coupling, manual duty, double-step and zero-cross
    - dimmer: free-running half-cycle grid; a zero-cross only re-locks it inside a narrow window, so a triac-firing burst can no longer cancel the other channel's gate (the iron used to switch the heater off). TIM3 and EXTI share one NVIC priority so schedule_half() cannot be re-entered.
    - main: one source of truth for CH1 duty (manual > PID, overtemp wins over both), written every pass so dimmer/LCD/LED agree; overtemp trips after 3 consecutive cycles; Dimmer_Init() before the timer starts; CH2 pin actually configured; zero-cross rising edge only with no internal pull-up; LEDs start off.
    - keys: 30 ms debounce plus 150 ms mini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
2026-10-27 chore: keep the LED map and zero-cross mode after a CubeMX regenerate
    The .ioc still had PB12 labelled ERR, PB14 labelled CH2 and PC7 on both edges, so generating code again would have swapped the LEDs back and doubled the EXTI load. The LED-off write now also lives in USER CODE 2 so the splash cannot light all three LEDs.
2026-10-28 fix: calibrate the Type-K front end and stop the reading/PID chatter
    - temp: use the measured front end instead of the schematic's nominal gain.
    25 C -> 7 mV at PA0 is the amplifier offset, 450 C -> 1250 mV gives
    G = (1250-7)/17.477 = 71.12. With 150.7 the firmware read ~219 C for a
    real 450 C, so the PID chased an unreachable setpoint. Re-calibration
    steps are documented in temp.c and the constants now live in temp.h so
    the debug monitor uses the same numbers.
    - temp: replace the snap-to-outlier filter with clamp-then-average
    (MA_LEN 8, +/-30 C clamp vs. the window mean, 0.5 C output hysteresis)
    and tighten the single-sample deglitch to 80 counts (~11 C). A 500 C
    spike now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
2026-10-29 feat: 0.01% heater duty resolution, hardware files, README and docs
